hexaedron/CubeNixie_IN-18/Hardware/BOM_CubeNixie_2024-07-25.csv

ID | Name | Designator | Footprint | Quantity | Manufacturer Part | Manufacturer | Supplier | Supplier Part | Price
1 | 100nF | C1,C2,C3,C4,C5 | C1206 | 5 | C3216X7R2A104M160AA | TDK | LCSC | C3883507 | 0.455
2 | HDR-M-2.54_1x2 | J_DOTS,J_HW,J_VCC_HW1,J_VCC_HW2,J_VCC_HW3,J_VCC_HW4,J_VCC_HW5,J_VCC_HW6,J_VCC_HW7,J_VCC_HW8 | HDR-M-2.54_1X2 | 10 |  |  | LCSC | C124375 | 0.023
3 | HDR-M-2.54_1x20 | J_EXT | HDR-M-2.54_1X20 | 1 |  |  | LCSC | C50981 | 0.061
4 | HDR-M-2.54_1x5 | J_LAMP1,J_LAMP2,J_LAMP3,J_LAMP4,J_LAMP5,J_LAMP6,J_LAMP7,J_LAMP8 | HDR-M-2.54_1X5 | 8 |  |  | LCSC | C358687 | 0.025
5 | HDR-M-2.54_1x8 | J_SPI | HDR-M-2.54_1X8 | 1 |  |  | LCSC | C190820 | 0.037
6 | HDR-M-2.54_1x3 | J_VCC | HDR-M-2.54_1X3 | 1 |  |  | LCSC | C180248 | 0.181
7 | ARDUINO_NANO | LGT8F328P | COMM-TH_ARDUINO_NANO | 1 | ARDUINO_NANO | null | LCSC | C9900017879
8 | AT24C02N | MEM1 | DIP-8_L9.2-W6.3-P2.54-LS7.62-BL | 1 | AT24C02N | HGSEMI | LCSC | C434606 | 0.114
9 | 1kΩ | R_DOTS,R_TLP1,R_TLP2,R_TLP3,R_TLP4,R_TLP5,R_TLP6,R_TLP7,R_TLP8,R_TLP9,R_TLP10,R_TLP11,R_TLP12,R_TLP13,R_TLP14,R_TLP15,R_TLP16,R_TLP17,R_TLP18,R_TLP19,R_TLP20,R_TLP21,R_TLP22,R_TLP23,R_TLP24,R_TLP25,R_TLP26,R_TLP27,R_TLP28,R_TLP29,R_TLP30,R_TLP31,R_TLP32,R_TLP33,R_TLP34,R_TLP35,R_TLP36,R_TLP37,R_TLP38,R_TLP39,R_TLP40 | R0805 | 41 | ERJ6ENF1001V | PANASONIC(松下) | LCSC | C79496 | 0.006
10 | 4.7kΩ | R_SCL,R_SDA | R0402 | 2 | RMC04024K7JN | Tyohm(幸亚电阻) | LCSC | C269679 | 0.002
11 | TM74HC595D | SHIFT_1,SHIFT_2,SHIFT_3,SHIFT_4,SHIFT_5 | SOP-16_L10.0-W3.9-P1.27-LS6.0-BL | 5 | TM74HC595 | TM(天微) | LCSC | C79097 | 0.072
12 | TLP627-4(F) | U1,U2,U3,U4,U5,U6,U7,U8,U9,U10 | DIP-16_L20.0-W6.4-P2.54-LS7.6-BL | 10 | TLP627-4(F) | TOSHIBA(东芝) | LCSC | C2987290 | 4.092
13 | TLP627(F) | U11 | DIP-4_L6.4-W4.6-P2.54-LS7.6-BL | 1 | TLP627(F) | TOSHIBA(东芝) | LCSC | C96253 | 0.384
14 | 1000nF | U_DECOUPL | CAP-TH_L10.5-W5.0-P7.50-D1.2 | 1 | CL21-0.1uF400V 5% | Tongfeng(铜峰电子) | LCSC | C281835
