hexaedron/CubeNixie_IN-18/Hardware/Schematic_CubeNixie_2024-07-25.pdf

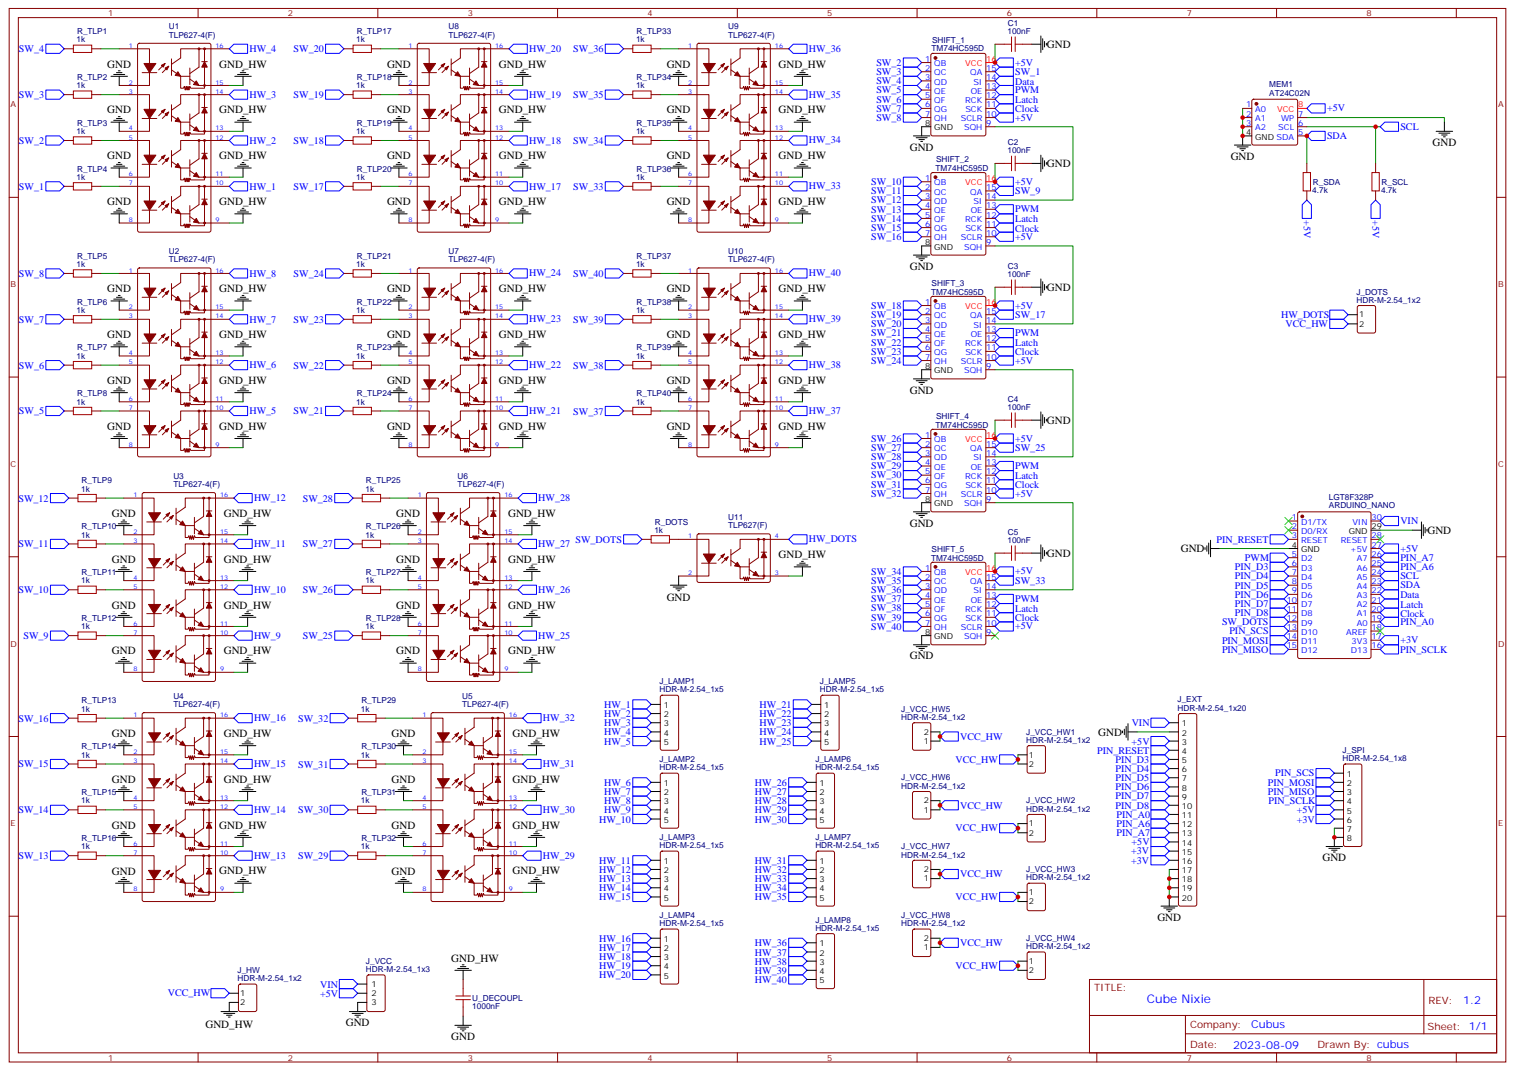
[picture p1: page 1]
