hexaedron/CubeNixie_IN-18/(list of files, drawings)

Other design files:
Hardware/PCB_PCB_CubeNixie_2024-07-25.json
Hardware/SCH_CubeNixie_2024-07-25.json
