hexaedron/CubeNixie_IN-18/(commit log)

2024-03-08 Первично написал проект. Осталось дописать populateIN18() и поправть неизбежные ошибки.
2024-03-27 Будет NTP вместо GPS
2024-03-27 Добавил вотчдог
2024-04-18 Сделал заполнение массива байт, отправляемого в регистры.
2024-04-18 Поправил неправильный порядок ножек у U7
2024-04-18 Теперьслучайное время смещения рассчитвается по последнему байту GUID
2024-04-18 Добавил анимацию каждые 10 мин
2024-04-21 Пофиксил порядок следования бит
2024-07-22 Поправил порядок байт в регистрах сдвига
2024-07-22 Поправил анимации и добавил яркости.
2024-07-23 Подправил яркость
2024-07-23 Увеличил время работы вотчдога до 4 с и добавил включение точек сразу после запуска.
2024-07-25 Поправил анимации и чуть убавил яркость
2024-07-25 Добавил платы и описание
    [BOM_CubeNixie_2024-07-25.csv, PCB_PCB_CubeNixie_2024-07-25.json, SCH_CubeNixie_2024-07-25.json]
2024-07-28 Наконец поправил анимацию.
